WarriorOx/SolderOven/Design Outputs/Solder-Oven-PCB-Front.png

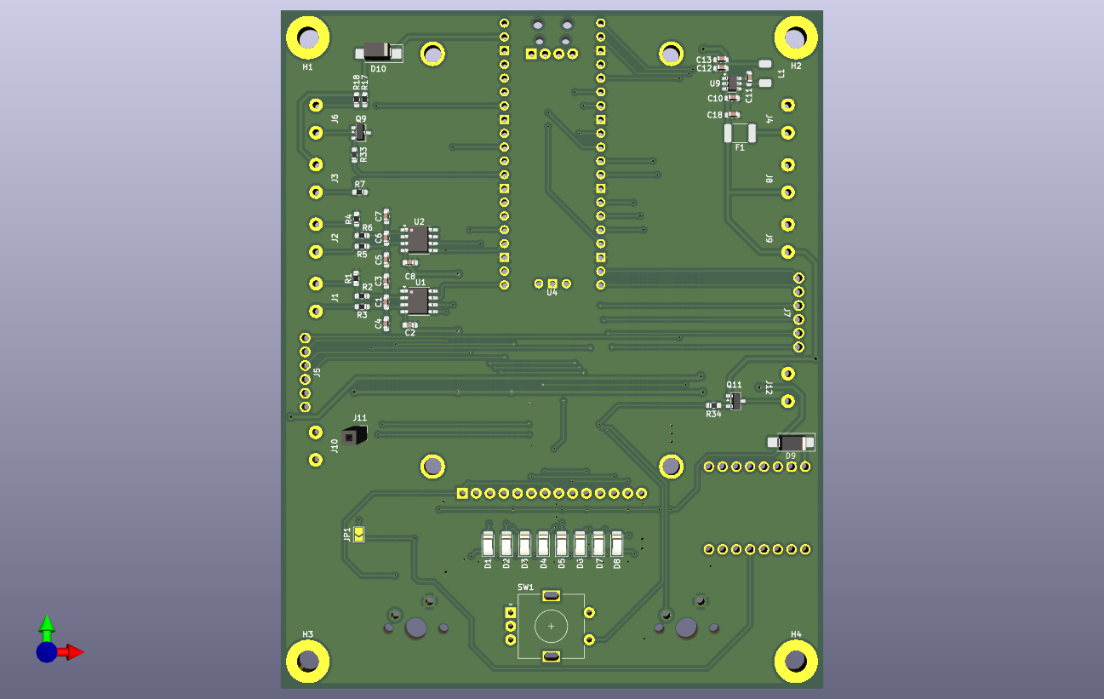
Design Outputs/Solder-Oven-PCB-Front.png
