WarriorOx/SolderOven/Design Outputs/Solder-Oven-PCB-Rear.png

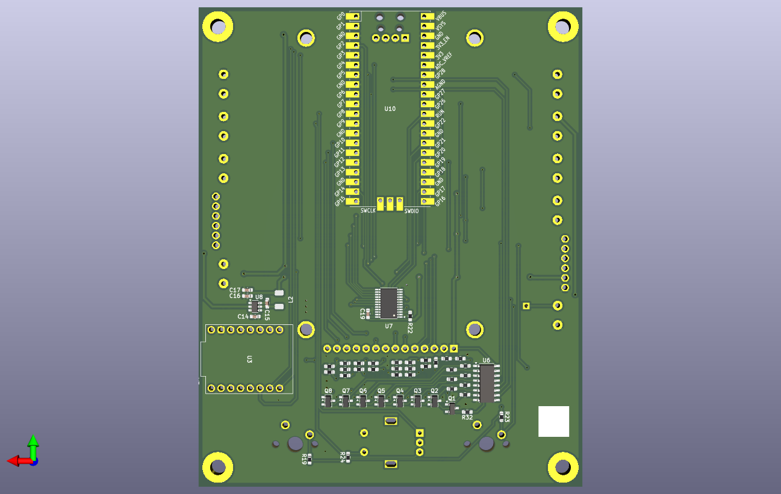
Design Outputs/Solder-Oven-PCB-Rear.png
