WarriorOx/SolderOven/KiCad-Templates-Libraries/README.md

# KiCad Templates & Libraries
## Description
This repository is a collection of KiCad PCB templates, schematic libraries, footprint libraries and 3D models of components. This repository is intended to be added as a sub-module of each PCB project so that libraries can be updated and managed independantly from the PCB project itself.
## Addition Instructions
To add this library to an existing git repo use `git submodule add http://192.168.2.202/WarriorOx/KiCad-Templates-Libraries.git PROJECT_FOLDER/KiCad-Templates-Libraries`

This will allow for the libraries to be referenced relative to the KiCad project instead of needing to be changed when used on a different computer.
<<<<<<< HEAD
<h3>Included Libraries</h3>
*Updated Nov. 28, 2024*
=======
## Included Libraries
*Updated Nov. 26, 2024 *
>>>>>>> 32c0e4cfd789ac8a733560780b6e95adb8c2da2a

- Arduino-Accessories (AliExpress PCB modules designed for use with Arduinos)
- Connectors_Terminals (Screw terminals and Misc. connectors)
- ESP-32 (ESP32 footprints and schematic symbols)
- Inductors (Inductor Footprints)
- IO-Expanders (I/O expanders, I2C and SPI, including DAC, ADC and PWM)
- JLC-X-layer-template (Template KiCad project for X layer PCB with proper design rules)
- MX_Alps_Hybrid-master (MX-style keyswitch footprints for hotswap and regular)
- Random-Keyboard-Parts (Misc. keyboard parts including LEDs and MCUs)
- RP_Pico (Schematic symbol, Footprint and 3D models of Raspberry Pi Pico)
- USB-Ports (Collection of USB ports from LCSC, various data rates)

## Notes
**Need to fix 24 pin USB-C port footprint**
