WarriorOx/SolderOven/Design Outputs/Schematic P1.png

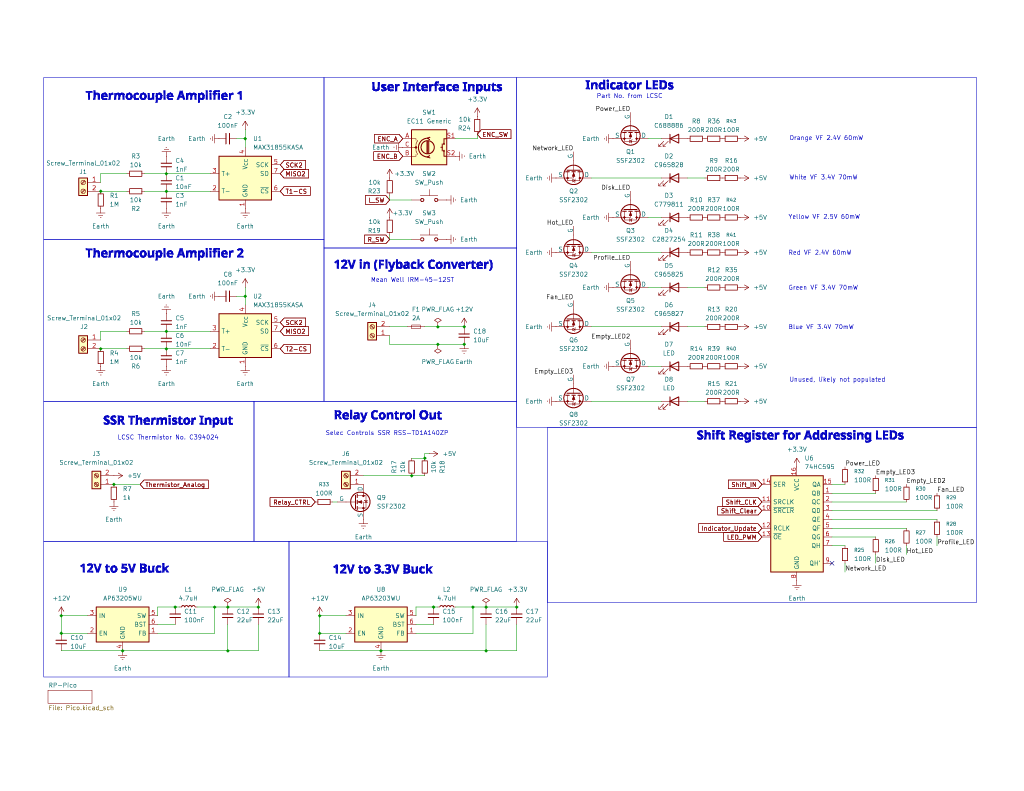
Design Outputs/Schematic P1.png
