WarriorOx/SolderOven/Design Outputs/Schematic P2.png

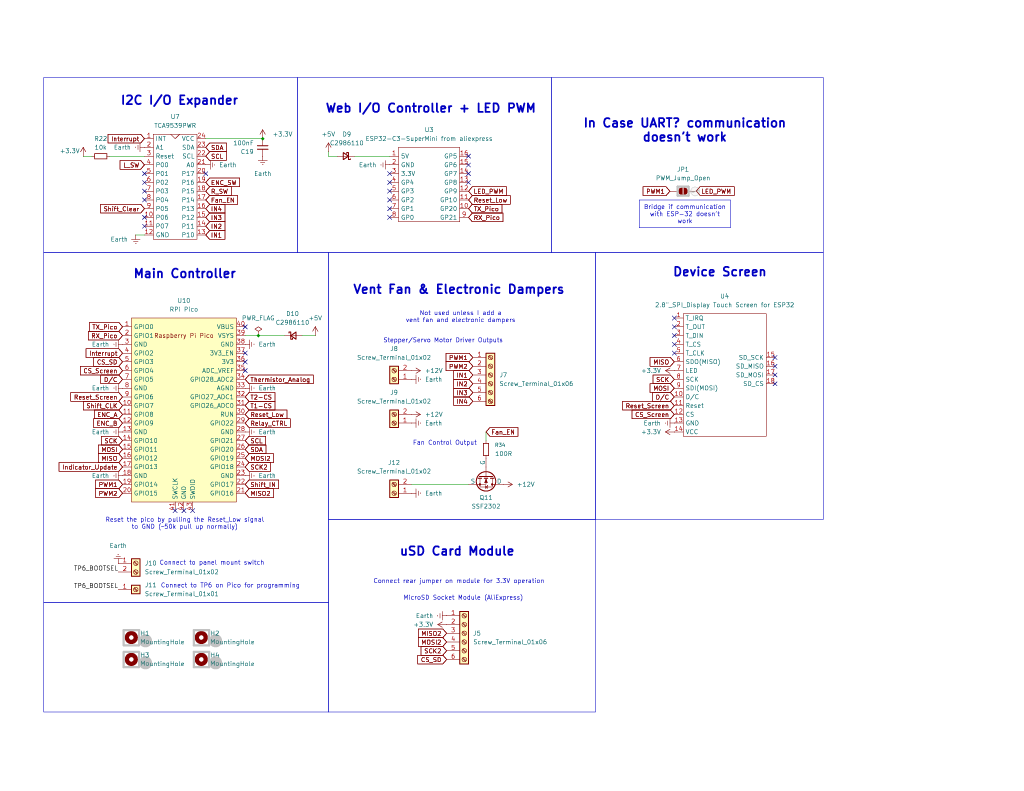
Design Outputs/Schematic P2.png
