WarriorOx/SolderOven/Solder-Oven-BOM.pdf

## Solder-Oven-BOM

Reference | Value | Footprint | Qty | Description | Link
C1,C6 | 10nF | Capacitor_SMD:C_0603_1608M | 2 | Unpolarized capacitor | LCSC(100) (https://www.lcsc.com/product-detail/Multilayer-Ceramic-Capacitors-MLCC-SMD-SMT_YAGEO-CC0603KRX7R8BB103_C327204.html)
C2,C8,C11,C15,C19 | 100nF | Capacitor_SMD:C_0603_1608M | 5 | Unpolarized capacitor | LCSC(100) (https://www.lcsc.com/product-detail/Multilayer-Ceramic-Capacitors-MLCC-SMD-SMT_Walsin-Tech-Corp-0603B104K160CT_C80516.html)
C3,C4,C5,C7 | 1nF | Capacitor_SMD:C_0603_1608M | 4 | Unpolarized capacitor | LCSC(100) (https://www.lcsc.com/product-detail/Multilayer-Ceramic-Capacitors-MLCC-SMD-SMT_Walsin-Tech-Corp-0603B102K160CT_C163169.html)
C10,C14,C18 | 10uF | Capacitor_SMD:C_0603_1608M | 3 | Unpolarized capacitor | LCSC(20) (https://www.lcsc.com/product-detail/Multilayer-Ceramic-Capacitors-MLCC-SMD-SMT_Samsung-Electro-Mechanics-CL10A106MA8NRNC_C96446.html)
C12,C13,C16,C17 | 22uF | Capacitor_SMD:C_0603_1608M | 4 | Unpolarized capacitor | LCSC(30) (https://www.lcsc.com/product-detail/Multilayer-Ceramic-Capacitors-MLCC-SMD-SMT_Samsung-Electro-Mechanics-CL10A226MP8NUNE_C86295.html)
D1 | Orange LED | LED_SMD:LED_1206_3216Metri | 1 | | LCSC(50) (https://www.lcsc.com/product-detail/LED-Indication-Discrete_TUOZHAN-TZ-P2-1206-0-TCS2-1-0T_C688886.html)
D2 | White LED | LED_SMD:LED_1206_3216Metri | 1 | | LCSC(50) (https://www.lcsc.com/product-detail/LED-Indication-Discrete_XINGLIGHT-XL-3216UWC_C965828.html)
D3 | Yellow LED | LED_SMD:LED_1206_3216Metri | 1 | | LCSC(50) (https://www.lcsc.com/product-detail/LED-Indication-Discrete_TUOZHAN-TZ-P2-1206YTCS2-0-9T_C779811.html)
D4 | Red LED | LED_SMD:LED_1206_3216Metri | 1 | | LCSC(50) (https://www.lcsc.com/product-detail/LED-Indication-Discrete_TUOZHAN-P2-1206RTCS2-0-9T-F_C2827254.html)
D5 | Green LED | LED_SMD:LED_1206_3216Metri | 1 | | LCSC(50) (https://www.lcsc.com/product-detail/LED-Indication-Discrete_XINGLIGHT-XL-3216UGC_C965825.html)
D6 | Blue LED | LED_SMD:LED_1206_3216Metri | 1 | | LCSC(50) (https://www.lcsc.com/product-detail/LED-Indication-Discrete_XINGLIGHT-XL-3216UBC_C965827.html)
D7,D8 | LED | LED_SMD:LED_1206_3216Metri | 2
D9,D10 | C2986110 | Diode_SMD:D_SMA_Handsolder | 2 | Schottky diode | LCSC(50) (https://www.lcsc.com/product-detail/Schottky-Diodes_GOODWORK-SS14_C2986110.html)
F1 | 2A | Fuse:Fuse_1812_4532Metric_P | 1 | Fuse | LCSC(5) (https://www.lcsc.com/product-detail/Resettable-Fuses_Bel-span-style-background-color-ff0-Fuse-span-0ZCG0110BF2B_C3760730.html)
J1,J2,J3,J4,J6,J8,J9, J10,J12 | Screw_Termin al_01x02 | Connectors_Terminals:1x2 5.0 | 9 | 1x2 5.08mm Screw Terminal | LCSC(50) (https://www.lcsc.com/product-detail/Screw-Terminal-Blocks_JILN-JL500-50802G01_C709041.html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)
J5,J7 | Screw_Termin al_01x06 | Connectors_Terminals:1x6 2.5 | 2 | 1x6 2.54mm Screw Terminal | LCSC(2) (https://www.lcsc.com/product-detail/Screw-Terminal-Blocks_MAX-MX128-2-54-06P-GN01-Cu-Y-A_C5188446.html)
J11 | Screw_Termin al_01x01 | Solder a wire to it | 1 | 1x1 2.54mm Pin Header
L1,L2 | 4.7uH | Inductors:LCSCC22463808 | 2 | Inductor | LCSC(5) (https://www.lcsc.com/product-detail/Inductors-SMD_TECHFUSE-SL0420-4R7M_C22463808.html)
Q1,Q2,Q3,Q4,Q5,Q6, Q7,Q8,Q9,Q11 | SSF2302 | Package_TO_SOT_SMD:SOT-23 | 10 | N-MOSFET transistor, drain/source/gate
R1,R4 | 1M | Resistor_SMD:R_0603_1608Met | 2 | Resistor | LCSC(100) (https://www.lcsc.com/product-detail/Chip-Resistor-Surface-Mount_FOJAN-FRC0603F1004TS_C2907003.html)
R2,R3,R5,R6,R17,R18 ,R22 | 10k | Resistor_SMD:R_0603_1608Met | 7 | Resistor
R7 | 1k | Resistor_SMD:R_0603_1608Met | 1 | Resistor | LCSC(100) (https://www.lcsc.com/product-detail/Chip-Resistor-Surface-Mount_VO-SCR0603J1K_C3017736.html)
R8,R9,R10,R11,R12,R 13,R14,R15,R16,R20, R21 | 200R | Resistor_SMD:R_0603_1608Met | 11 | Resistor
SW1 | EC11 Generic | Rotary_Encoder:RotaryEncode | 1 | Rotary encoder
SW2,SW3 | SW_Push | MX_Only:MXOnly-1U-NoLED | 2 | Push button switch, generic, two pins
U1,U2 | MAX31855KAS A | Package_SO:SOIC-8_3.9x4.9 | 2 | Cold Junction K-type Thermocouple Interface, SPI, SOIC-8 | LCSC(2) (https://www.lcsc.com/product-detail/ADCs-DACs-Special-Purpose_Analog-Devices-Inc-Maxim-Integrated-MAX31855KASA-T_C52028.html)
U3 | ESP32-C3-SuperMini | ESP-32:ESP32-C3_SUPERMINI | 1 | 2x 1x8 2.54mm pins

U4 | 2.8"_SPI_Displ ay Touch Screen | Arduino-Accesories:2.8in TFT D | 1 | 1x14 2.54mm pins
U5 | TCA9539PWR | Package_SO:TSSOP-24_4.4x7 | 1 | I2C I/O Expander | LCSC(1) (https://www.lcsc.com/product-detail/I-O-Expanders_Texas-Instruments-TCA9539PWR_C131972.html)
U6 | 74HC595 | Package_SO:SOP-16_3.9x9.9 | 1 | 8-bit serial in/out Shift Register 3-State Outputs | LCSC(10) (https://www.lcsc.com/product-detail/Shift-Registers_GR-74HC595_C18164493.html)
U8 | AP63203WU | Package_TO_SOT_SMD:TSOT-2 | 1 | 2A, 1.1MHz Buck DC/DC Converter, fixed 3.3V output voltage, TSOT-23-6 | LCSC(5) (https://www.lcsc.com/product-detail/DC-DC-Converters_Diodes-Incorporated-AP63203WU-7_C780769.html)
U9 | AP63205WU | Package_TO_SOT_SMD:TSOT-2 | 1 | 2A, 1.1MHz Buck DC/DC Converter, fixed 5.0V output voltage, TSOT-23-6 | LCSC(1) (https://www.lcsc.com/product-detail/DC-DC-Converters_Diodes-Incorporated-AP63205WU-7_C2071056.html)
U10 | RPi Pico | RPI-Pico:RPi_Pico_SMD_TH | 1 | 2x 1x20 2.54mm pins
| Solid State Relay | | 1 | | Digikey(1) (https://www.digikey.ca/en/products/detail/picker-components/PCS15-D-240A-40ZL/20994534)
R25,R26,R27,R28,R2 9,R30,R31,R32,R33,R 34,R40,R41,R42,R43 | 100R | Resistor_SMD:R_0603_1608Met | 14 | Resistor
| 1x8 2.54mm pin header Male | ESP-32:ESP32-C3_SUPERMINI | 2 | Male Pins | LCSC(10) (https://www.lcsc.com/product-detail/Pin-Headers_DEALON-DZ254R-11-08-63_C2935914.html)
| 1x8 2.54mm pin header Female | ESP-32:ESP32-C3_SUPERMINI | 2 | Female Pins | LCSC(10) (https://www.lcsc.com/product-detail/Female-Headers_JILN-22850108ANG1SYA01_C429957.html)
| 1x14 2.54mm pin header Male | Arduino-Accesories:2.8in TFT D | 1 | Male Pins | LCSC(10) (https://www.lcsc.com/product-detail/Pin-Headers_CONNFLY-Elec-DS1021-1x14SF11-B_C7430370.html)
| 1x14 2.54mm pin header Female | Arduino-Accesories:2.8in TFT D | 1 | Female Pins | LCSC(5) (https://www.lcsc.com/product-detail/Female-Headers_Shenzhen-Kinghelm-Elec-KH-2-54FH-1X14P-H8-5_C2905420.html)
| 1x20 2.54mm pin header Male | RPI-Pico:RPi_Pico_SMD_TH | 2 | Male Pins | LCSC(10) (https://www.lcsc.com/product-detail/Pin-Headers_JILN-12251120CNG0S115005_C429964.html)
| 1x20 2.54mm pin header Female | RPI-Pico:RPi_Pico_SMD_TH | 2 | Female Pins | LCSC(5) (https://www.lcsc.com/product-detail/Female-Headers_Shenzhen-Kinghelm-Elec-KH-2-54FH-1X20P-H8-5_C2905423.html)
| 16mm Panel Mount Switch | BOOTSEL Button | 1 | | AliExpress(1) (https://www.aliexpress.com/item/4000830670631.html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)
| | | 1 | Panel Mount USB-C to USB-C | AliExpress(1) (https://www.aliexpress.com/item/1005006161284502.html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)

1 | Panel Mount USB-C to Micro B | AliExpress(1) (https://www.aliexpress.com/item/1005006161284502.html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)
1 | Mean Well 12V 3.8A PSU | Digikey(1) (https://www.digikey.ca/en/products/detail/mean-well-usa-inc/irm-45-12st/7704683)
