WarriorOx/SolderOven/Design Outputs/BOM2.png

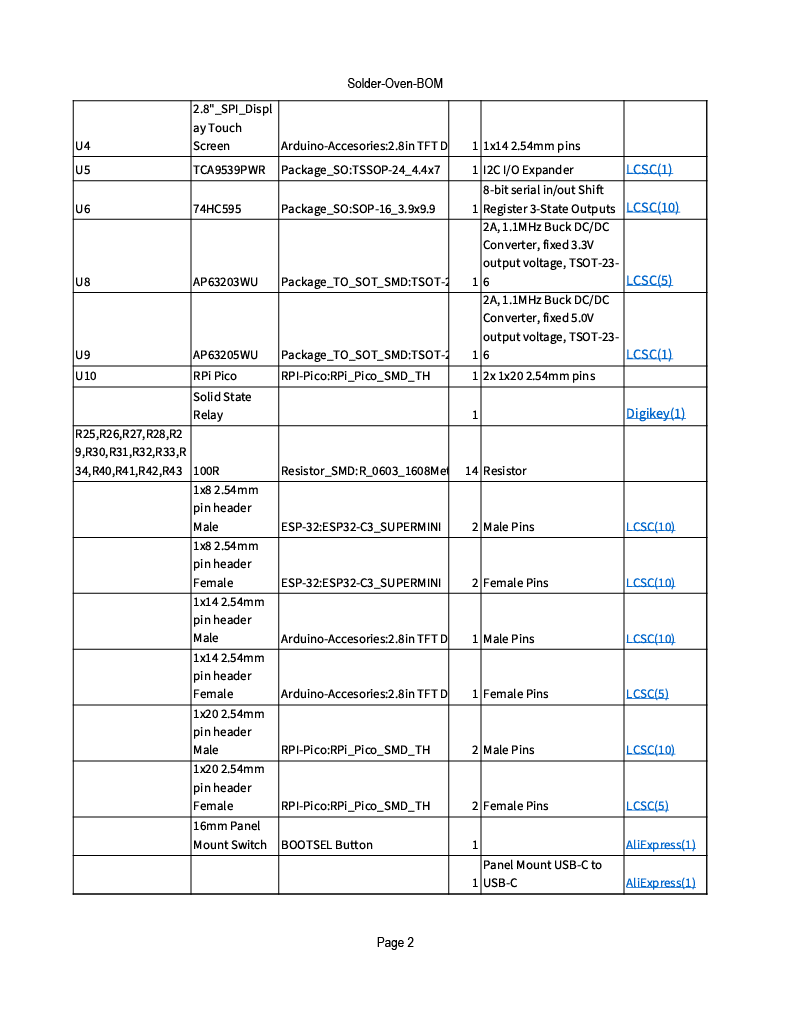
Design Outputs/BOM2.png
