WarriorOx/SolderOven/Design Outputs/BOM3.png

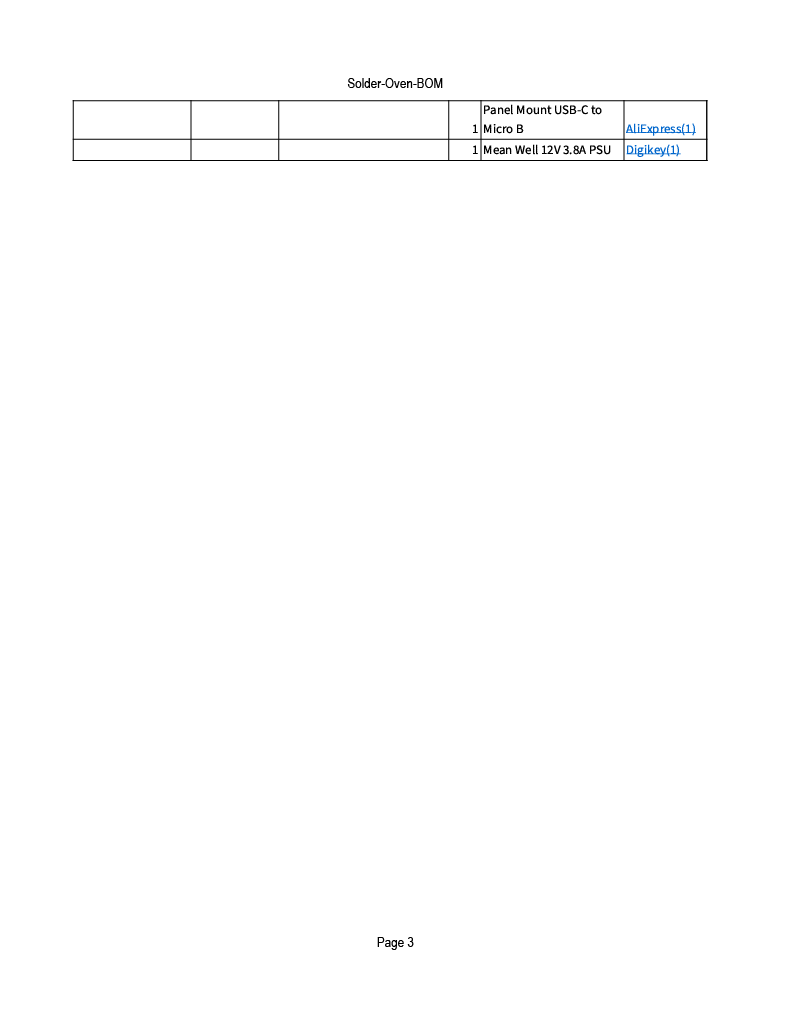
Design Outputs/BOM3.png
