WarriorOx/SolderOven/Design Outputs/BOM-1.png

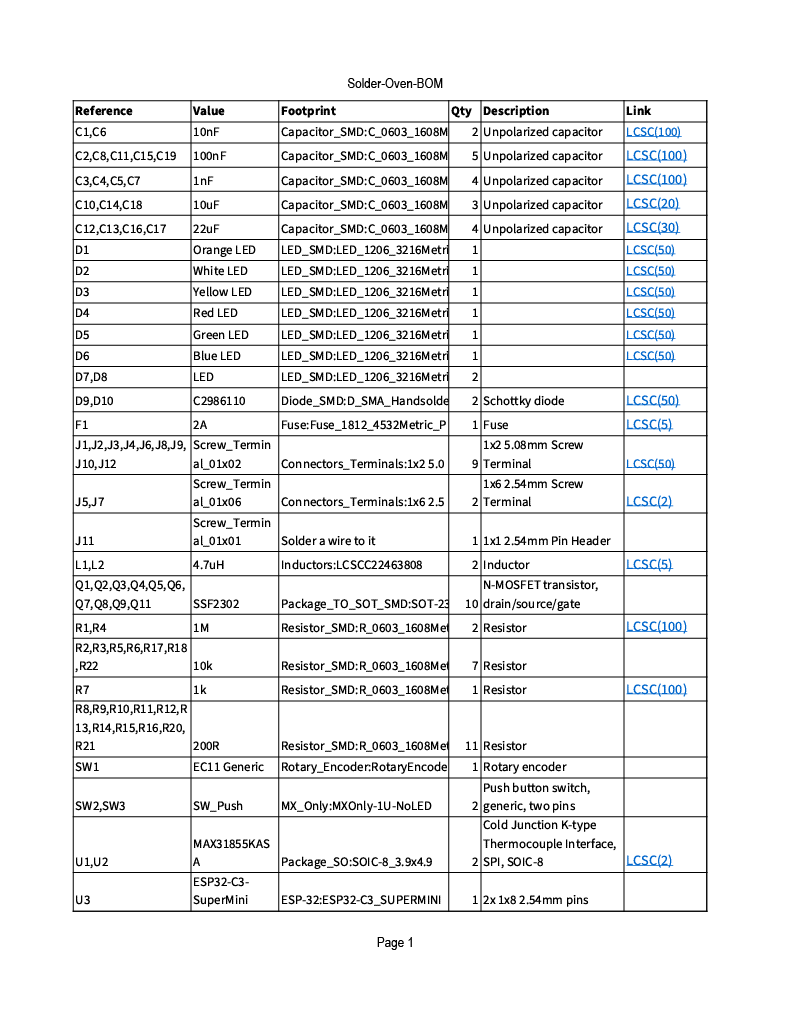
Design Outputs/BOM-1.png
