WarriorOx/SolderOven/Design Outputs/Solder Oven Front.png

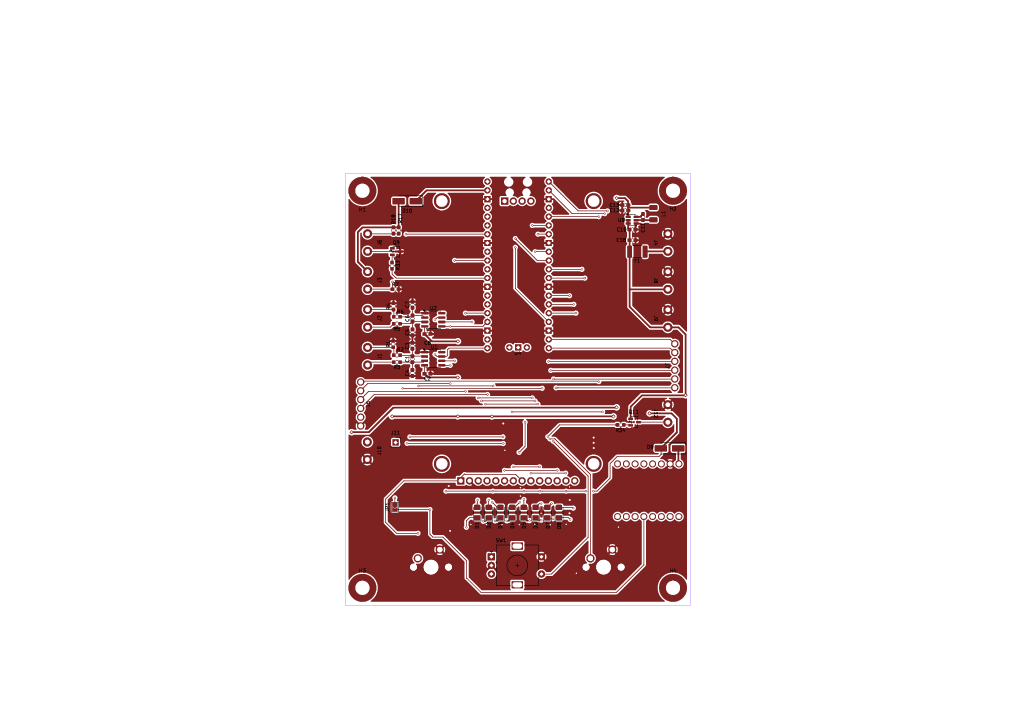
Design Outputs/Solder Oven Front.png
