WarriorOx/SolderOven/Design Outputs/Solder Oven Rear.png

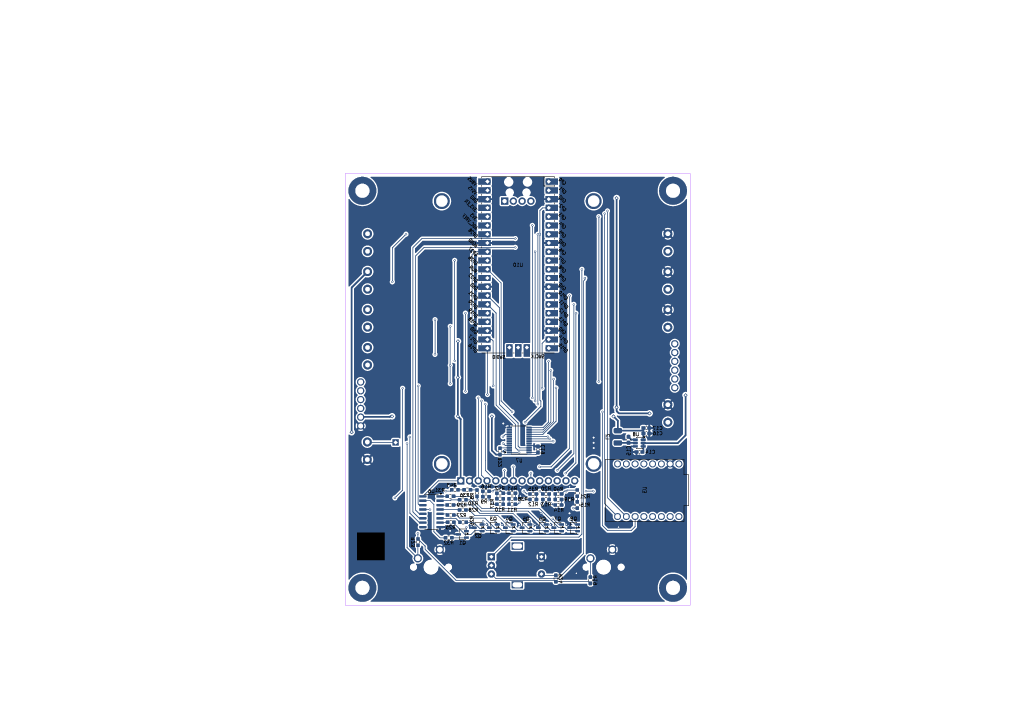
Design Outputs/Solder Oven Rear.png
