WarriorOx/SolderOven/Design Outputs/Schematics.pdf

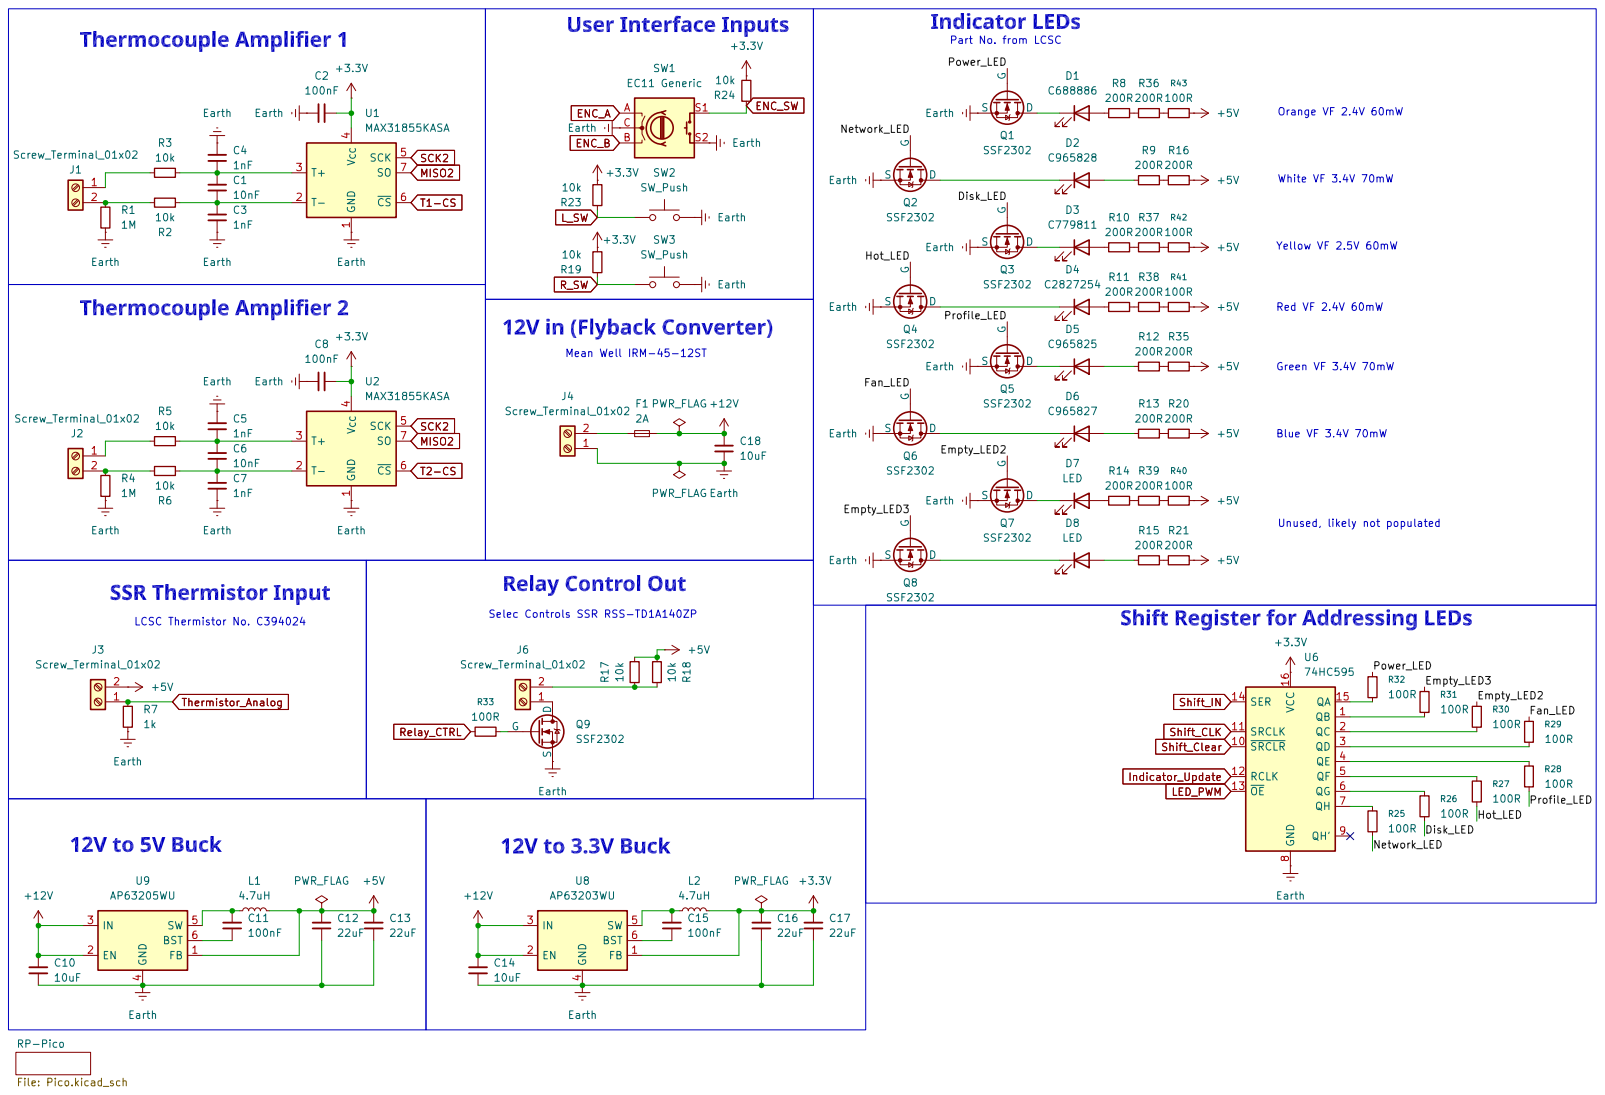
[picture p14: page 1]

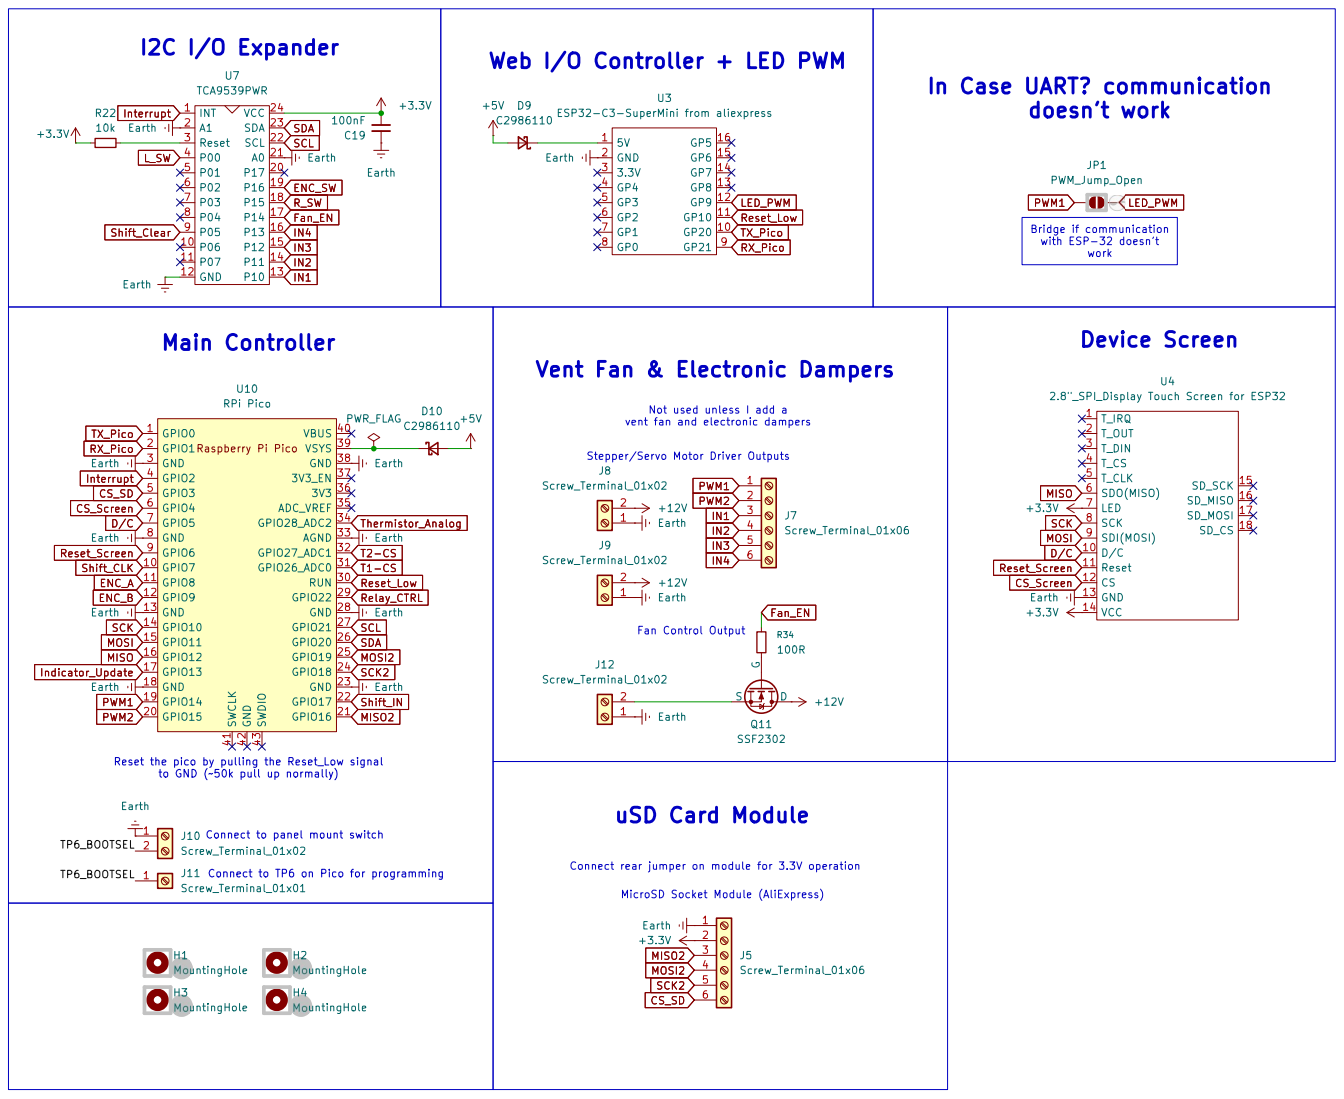
[picture p15: page 2]
