WarriorOx/SolderOven/Design Outputs/Solder Oven Front.pdf

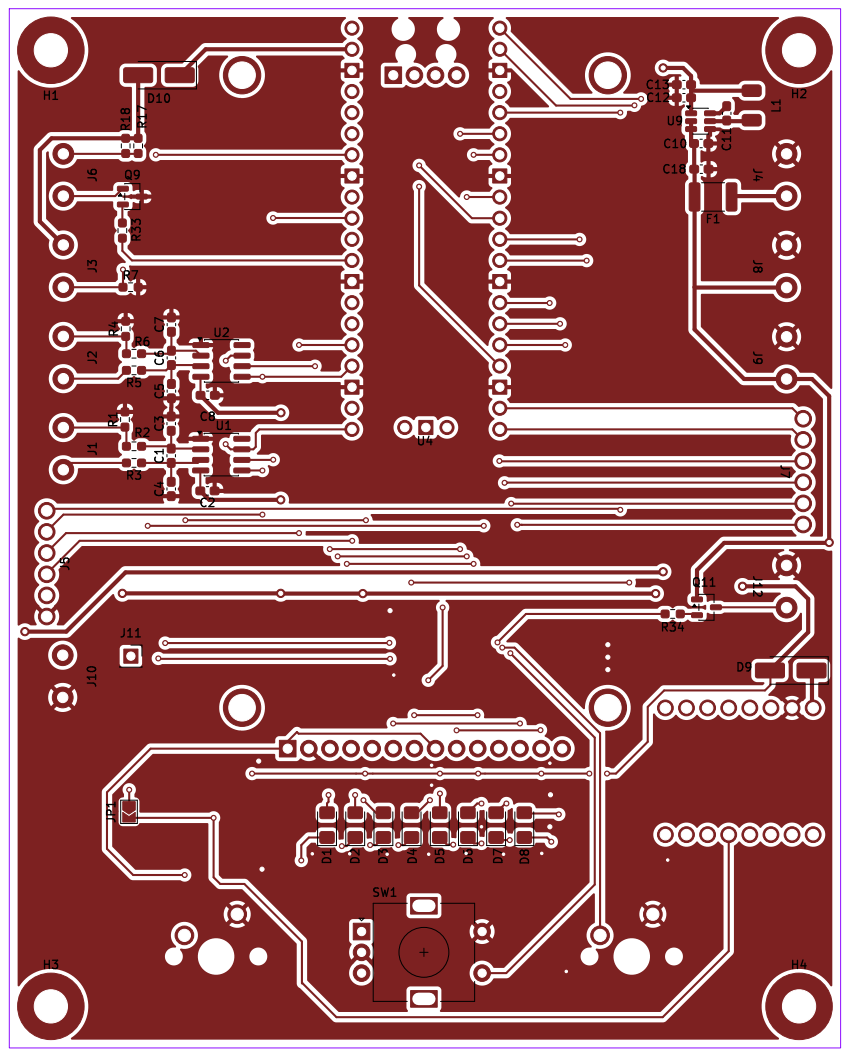
[picture p16: page 1]
