WarriorOx/SolderOven/Design Outputs/Solder Oven Rear.pdf

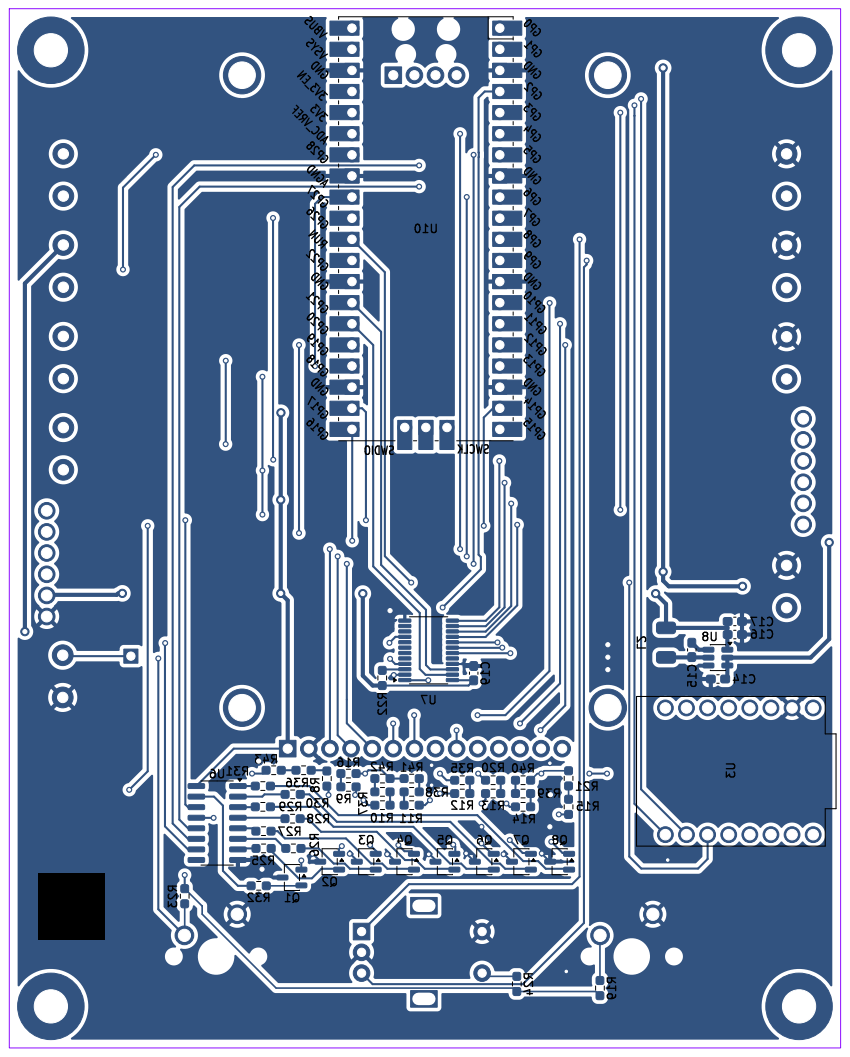
[picture p17: page 1]
