WarriorOx/SolderOven/Solder-Oven-PCB-V1.kicad_pcb

## KiCad design Solder-Oven-PCB-V1.kicad_pcb (2025-11-13)

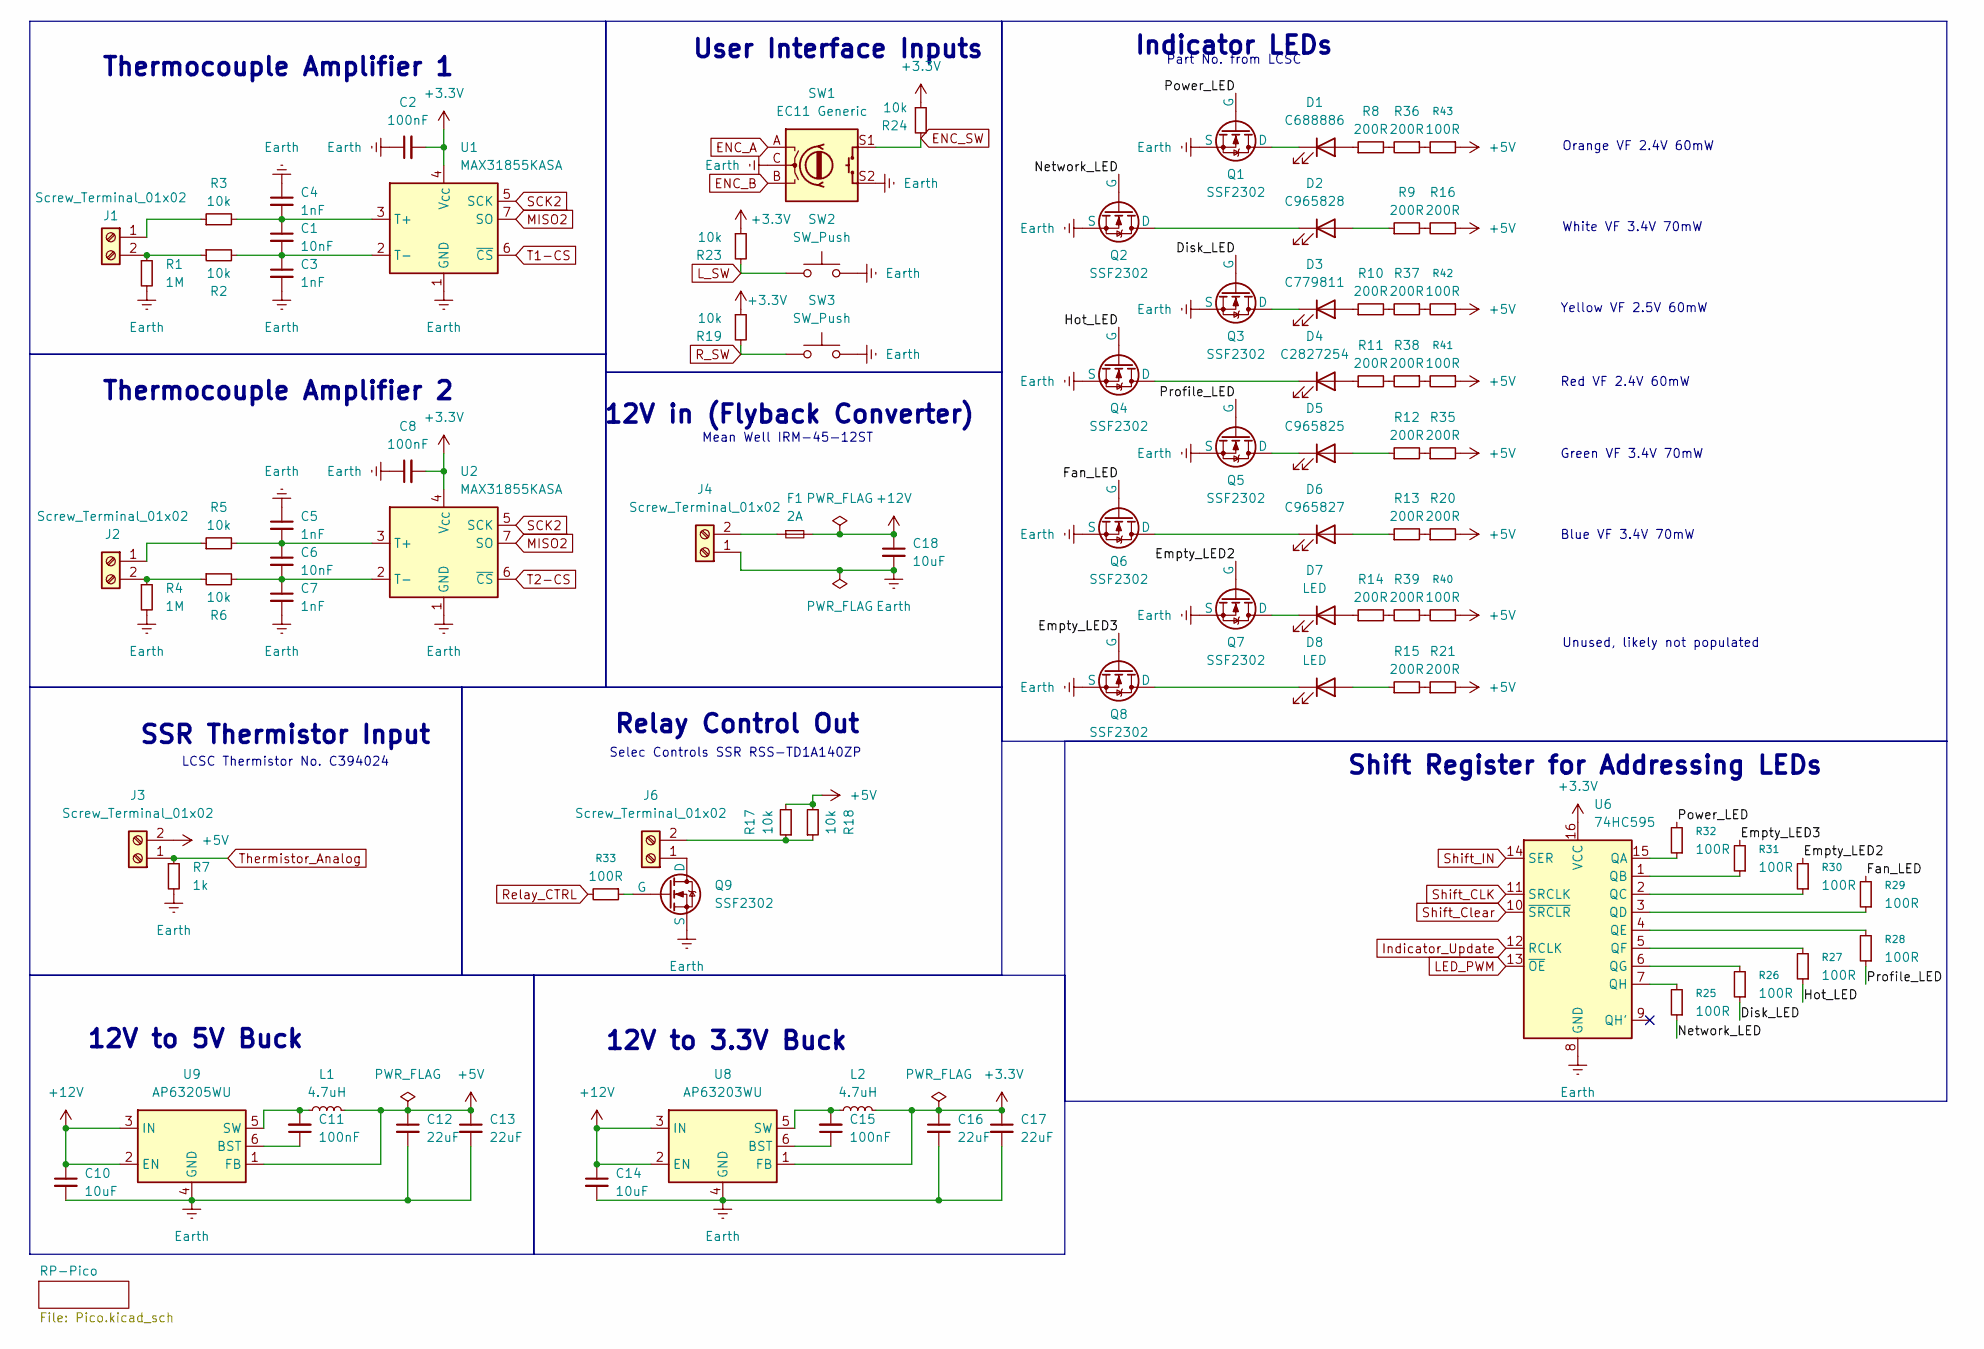
[picture p18: schematic Solder-Oven-PCB-V1.kicad_sch]

Parts:
C1, C6: 10nF; C_0603_1608Metric_Pad1.08x0.95mm_HandSolder
C2, C8, C11, C15: 100nF; C_0603_1608Metric_Pad1.08x0.95mm_HandSolder
C3, C4, C5, C7: 1nF; C_0603_1608Metric_Pad1.08x0.95mm_HandSolder
C10, C14, C18: 10uF; C_0603_1608Metric_Pad1.08x0.95mm_HandSolder
C12, C13, C16, C17: 22uF; C_0603_1608Metric_Pad1.08x0.95mm_HandSolder
D1: C688886; LED_1206_3216Metric_Pad1.42x1.75mm_HandSolder
D2: C965828; LED_1206_3216Metric_Pad1.42x1.75mm_HandSolder
D3: C779811; LED_1206_3216Metric_Pad1.42x1.75mm_HandSolder
D4: C2827254; LED_1206_3216Metric_Pad1.42x1.75mm_HandSolder
D5: C965825; LED_1206_3216Metric_Pad1.42x1.75mm_HandSolder
D6: C965827; LED_1206_3216Metric_Pad1.42x1.75mm_HandSolder
D7, D8: LED; LED_1206_3216Metric_Pad1.42x1.75mm_HandSolder
F1: 2A; Fuse_1812_4532Metric_Pad1.30x3.40mm_HandSolder
J1, J2, J3, J4, J6: Screw_Terminal_01x02; 1x2 5.08mm Screw Terminal
L1, L2: 4.7uH; LCSCC22463808
Q1, Q2, Q3, Q4, Q5, Q6, Q7, Q8, Q9: SSF2302; SOT-23-3
R1, R4: 1M; R_0603_1608Metric_Pad0.98x0.95mm_HandSolder
R2, R3, R5, R6, R17, R18, R19, R23, R24: 10k; R_0603_1608Metric_Pad0.98x0.95mm_HandSolder
R7: 1k; R_0603_1608Metric_Pad0.98x0.95mm_HandSolder
R8, R9, R10, R11, R12, R13, R14, R15, R16, R20, R21, R35, R36, R37, R38, R39: 200R; R_0603_1608Metric_Pad0.98x0.95mm_HandSolder
R25, R26, R27, R28, R29, R30, R31, R32, R33, R40, R41, R42, R43: 100R; R_0603_1608Metric_Pad0.98x0.95mm_HandSolder
SW1: EC11 Generic; RotaryEncoder_Alps_EC11E-Switch_Vertical_H20mm
SW2, SW3: SW_Push; MXOnly-1U-NoLED
U1, U2: MAX31855KASA; SOIC-8_3.9x4.9mm_P1.27mm
U6: 74HC595; SOP-16_3.9x9.9mm_P1.27mm
U8: AP63203WU; TSOT-23-6
U9: AP63205WU; TSOT-23-6

Connections:
+3.3V: C2.2, C8.2, C16.1, C17.1, L2.2, R19.1, R23.1, R24.1, U1.4 (V_{CC}), U2.4 (V_{CC}), U6.16 (VCC), U8.1 (FB); also elsewhere on the board
+5V: C12.1, C13.1, J3.2, L1.2, R16.1, R17.2, R18.2, R20.2, R21.2, R35.2, R40.1, R41.1, R42.1, R43.1, U9.1 (FB); also elsewhere on the board
+12V: C10.1, C14.1, C18.1, F1.2, U8.2 (EN), U8.3 (IN), U9.2 (EN), U9.3 (IN); also elsewhere on the board
/Disk_LED: Q3.2 (G), R26.1
/Empty_LED2: Q7.2 (G), R30.2
/Empty_LED3: Q8.2 (G), R31.2
/Fan_LED: Q6.2 (G), R29.2
/Hot_LED: Q4.2 (G), R27.1
/Network_LED: Q2.2 (G), R25.1
/Power_LED: Q1.2 (G), R32.2
/Profile_LED: Q5.2 (G), R28.1
ENC_A: SW1.A; also elsewhere on the board
ENC_B: SW1.B; also elsewhere on the board
ENC_SW: R24.2, SW1.S1; also elsewhere on the board
Earth: C2.1, C3.2, C4.1, C5.1, C7.2, C8.1, C10.2, C12.2, C13.2, C14.2, C16.2, C17.2, C18.2, J4.1, Q1.3 (S), Q2.3 (S), Q3.3 (S), Q4.3 (S), Q5.3 (S), Q6.3 (S), Q7.3 (S), Q8.3 (S), Q9.3 (S), R1.2, R4.2, R7.2, SW1.C, SW1.S2, SW2.2, SW3.2, U1.1 (GND), U2.1 (GND), U6.8 (GND), U8.4 (GND), U9.4 (GND); also elsewhere on the board
Indicator_Update: U6.12 (RCLK); also elsewhere on the board
LED_PWM: U6.13 (~OE); also elsewhere on the board
L_SW: R23.2, SW2.1; also elsewhere on the board
MISO2: U1.7 (SO), U2.7 (SO); also elsewhere on the board
unnamed: D1.2 (A), R8.1
unnamed: D1.1 (K), Q1.1 (D)
unnamed: D2.2 (A), R9.1
unnamed: D2.1 (K), Q2.1 (D)
unnamed: D3.2 (A), R10.1
unnamed: D3.1 (K), Q3.1 (D)
unnamed: D4.2 (A), R11.1
unnamed: D4.1 (K), Q4.1 (D)
unnamed: D5.2 (A), R12.1
unnamed: D5.1 (K), Q5.1 (D)
unnamed: D6.2 (A), R13.1
unnamed: D6.1 (K), Q6.1 (D)
unnamed: D7.2 (A), R14.1
unnamed: D7.1 (K), Q7.1 (D)
unnamed: D8.2 (A), R15.1
unnamed: D8.1 (K), Q8.1 (D)
unnamed: J1.1, R3.1
unnamed: J1.2, R1.1, R2.1
unnamed: J2.1, R5.1
unnamed: J2.2, R4.1, R6.1
unnamed: F1.1, J4.2
unnamed: J6.1, Q9.1 (D)
unnamed: J6.2, R17.1, R18.1
unnamed: Q9.2 (G), R33.1
unnamed: R10.2, R37.2
unnamed: R11.2, R38.2
unnamed: R12.2, R35.1
unnamed: R13.2, R20.1
unnamed: R14.2, R39.2
unnamed: R15.2, R21.1
unnamed: R9.2, R16.2
unnamed: R36.1, R43.2
unnamed: R8.2, R36.2
unnamed: R37.1, R42.2
unnamed: R38.1, R41.2
unnamed: R39.1, R40.2
unnamed: C1.1, C4.2, R3.2, U1.3 (T+)
unnamed: C1.2, C3.1, R2.2, U1.2 (T-)
unnamed: C5.2, C6.1, R5.2, U2.3 (T+)
unnamed: C6.2, C7.1, R6.2, U2.2 (T-)
unnamed: R32.1, U6.15 (QA)
unnamed: R31.1, U6.1 (QB)
unnamed: R30.1, U6.2 (QC)
unnamed: R29.1, U6.3 (QD)
unnamed: R28.2, U6.4 (QE)
unnamed: R27.2, U6.5 (QF)
unnamed: R26.2, U6.6 (QG)
unnamed: R25.2, U6.7 (QH)
unnamed: C15.1, U8.6 (BST)
unnamed: C15.2, L2.1, U8.5 (SW)
unnamed: C11.1, U9.6 (BST)
unnamed: C11.2, L1.1, U9.5 (SW)
R_SW: R19.2, SW3.1; also elsewhere on the board
Relay_CTRL: R33.2; also elsewhere on the board
SCK2: U1.5 (SCK), U2.5 (SCK); also elsewhere on the board
Shift_CLK: U6.11 (SRCLK); also elsewhere on the board
Shift_Clear: U6.10 (~SRCLR); also elsewhere on the board
Shift_IN: U6.14 (SER); also elsewhere on the board
T1-CS: U1.6 (~CS); also elsewhere on the board
T2-CS: U2.6 (~CS); also elsewhere on the board
Thermistor_Analog: J3.1, R7.1; also elsewhere on the board

Notes on the sheet:
Thermocouple Amplifier 1
Yellow VF 2.5V 60mW
Orange VF 2.4V 60mW
Part No. from LCSC
User Interface Inputs
White VF 3.4V 70mW
Thermocouple Amplifier 2
Mean Well IRM-45-12ST
12V to 3.3V Buck
Blue VF 3.4V 70mW
LCSC Thermistor No. C394024
Green VF 3.4V 70mW
Shift Register for Addressing LEDs
SSR Thermistor Input
Red VF 2.4V 60mW
Unused, likely not populated
12V to 5V Buck
Relay Control Out
Indicator LEDs
12V in (Flyback Converter)
Selec Controls SSR RSS-TD1A140ZP

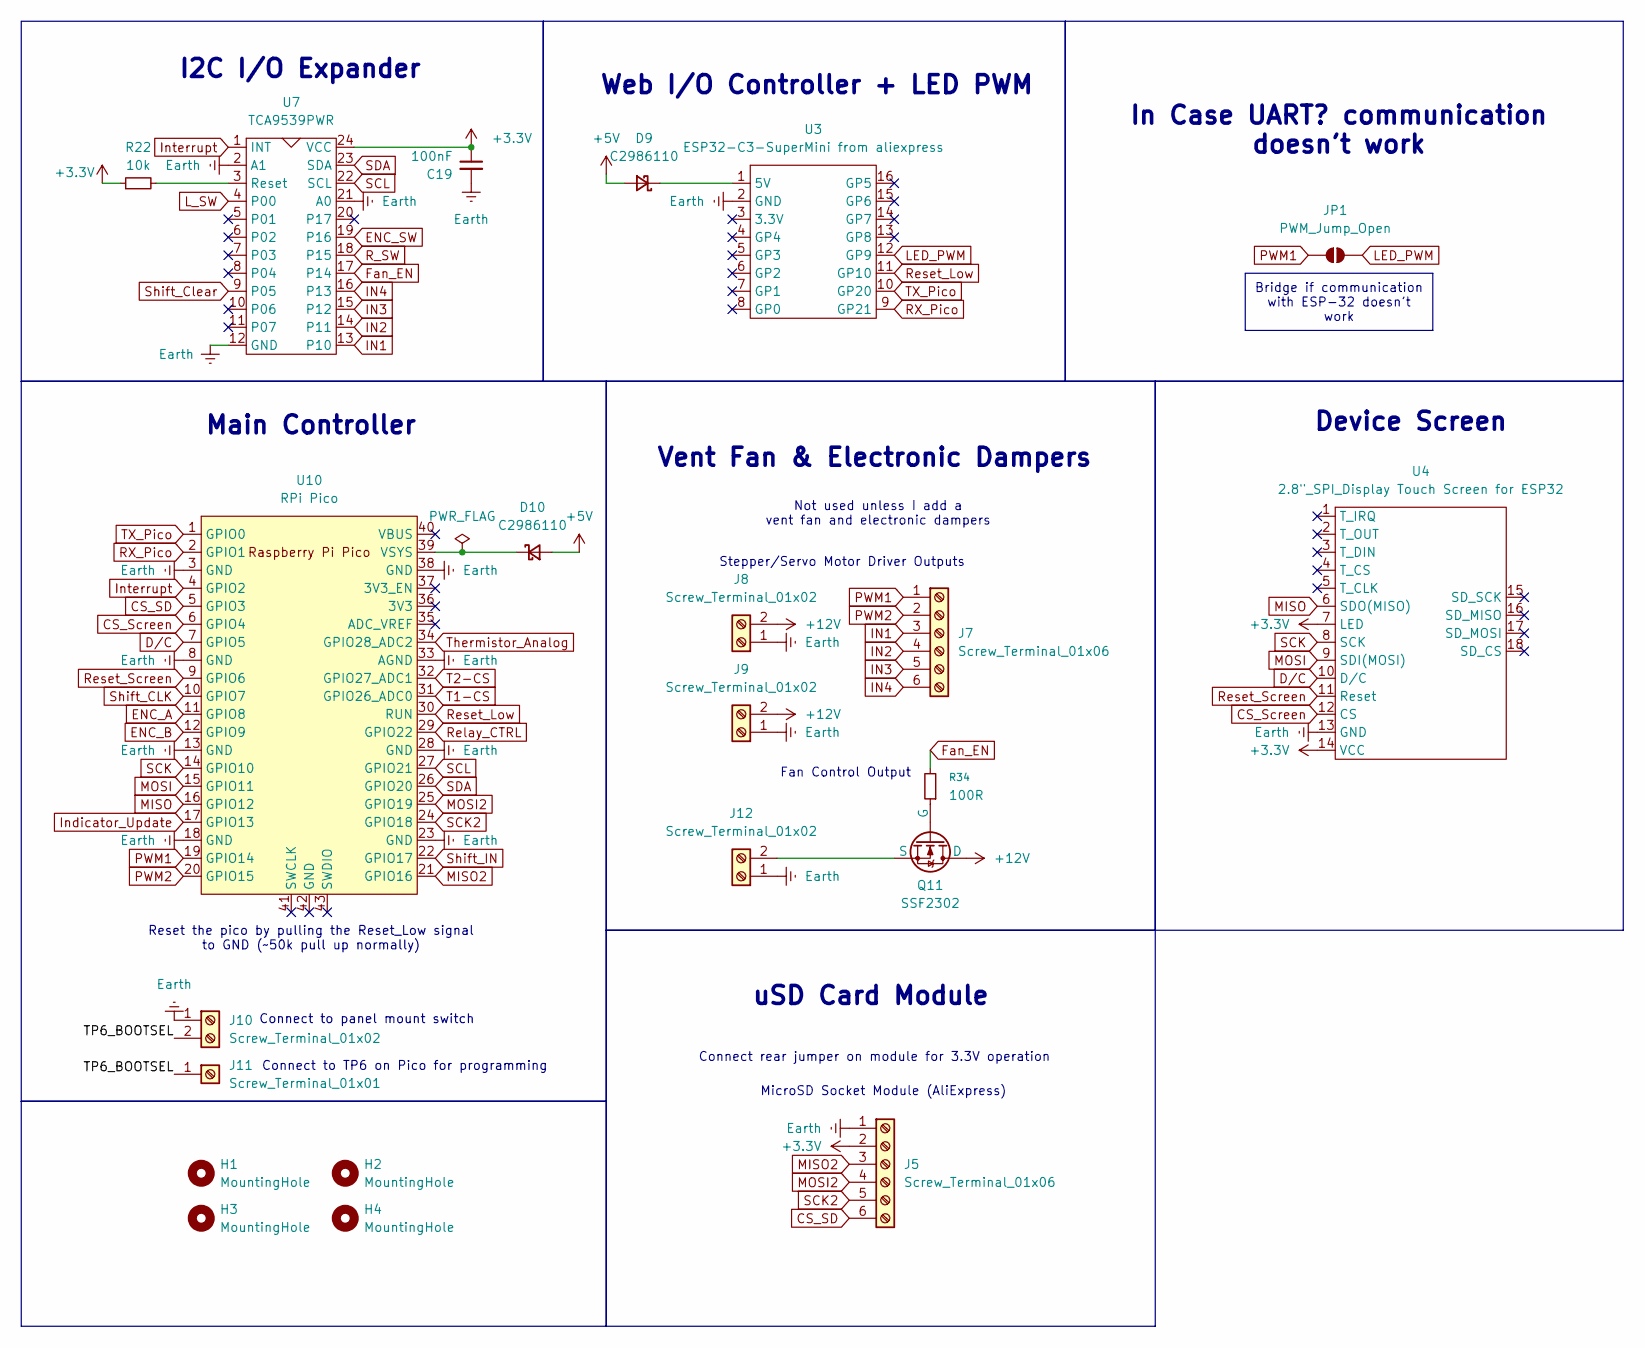
[picture p19: schematic Pico.kicad_sch]

Parts:
C19: 100nF; C_0603_1608Metric_Pad1.08x0.95mm_HandSolder
D9, D10: C2986110; D_SMA_Handsoldering
H1, H2, H3, H4: MountingHole; MountingHole_4mm_Pad
J5, J7: Screw_Terminal_01x06; 1x6 2.54mm Screw Terminal
J8, J9, J10, J12: Screw_Terminal_01x02; 1x2 5.08mm Screw Terminal
J11: Screw_Terminal_01x01; PinSocket_1x01_P2.54mm_Vertical
JP1: PWM_Jump_Open; SolderJumper-2_P1.3mm_Open_TrianglePad1.0x1.5mm
Q11: SSF2302; SOT-23-3
R22: 10k; R_0603_1608Metric_Pad0.98x0.95mm_HandSolder
R34: 100R; R_0603_1608Metric_Pad0.98x0.95mm_HandSolder
U3: ESP32-C3-SuperMini from aliexpress; ESP32-C3_SUPERMINI
U4: 2.8"_SPI_Display Touch Screen for ESP32; 2.8in TFT Display
U7: TCA9539PWR; TSSOP-24_4.4x7.8mm_P0.65mm
U10: RPi Pico; RPi_Pico_SMD_TH

Connections:
+3.3V: C19.1, J5.2, R22.1, U4.7 (LED), U4.14 (VCC), U7.24 (VCC); also elsewhere on the board
+5V: D9.2 (A), D10.2 (A); also elsewhere on the board
+12V: J8.2, J9.2, Q11.1 (D); also elsewhere on the board
/RP-Pico/TP6_BOOTSEL: J10.2, J11.1
CS_SD: J5.6, U10.5 (GPIO3)
CS_Screen: U4.12 (CS), U10.6 (GPIO4)
D/C: U4.10 (D/C), U10.7 (GPIO5)
ENC_A: U10.11 (GPIO8); also elsewhere on the board
ENC_B: U10.12 (GPIO9); also elsewhere on the board
ENC_SW: U7.19 (P16); also elsewhere on the board
Earth: C19.2, J5.1, J8.1, J9.1, J10.1, J12.1, U3.2 (GND), U4.13 (GND), U7.2 (A1), U7.12 (GND), U7.21 (A0), U10.3 (GND), U10.8 (GND), U10.13 (GND), U10.18 (GND), U10.23 (GND), U10.28 (GND), U10.33 (AGND), U10.38 (GND); also elsewhere on the board
Fan_EN: R34.2, U7.17 (P14)
IN1: J7.3, U7.13 (P10)
IN2: J7.4, U7.14 (P11)
IN3: J7.5, U7.15 (P12)
IN4: J7.6, U7.16 (P13)
Indicator_Update: U10.17 (GPIO13); also elsewhere on the board
Interrupt: U7.1 (INT), U10.4 (GPIO2)
LED_PWM: JP1.2 (B), U3.12 (GP9); also elsewhere on the board
L_SW: U7.4 (P00); also elsewhere on the board
MISO: U4.6 (SDO(MISO)), U10.16 (GPIO12)
MISO2: J5.3, U10.21 (GPIO16); also elsewhere on the board
MOSI: U4.9 (SDI(MOSI)), U10.15 (GPIO11)
MOSI2: J5.4, U10.25 (GPIO19)
unnamed: D9.1 (K), U3.1 (5V)
unnamed: D10.1 (K), U10.39 (VSYS)
unnamed: J12.2, Q11.3 (S)
unnamed: Q11.2 (G), R34.1
unnamed: R22.2, U7.3 (Reset)
PWM1: J7.1, JP1.1 (A), U10.19 (GPIO14)
PWM2: J7.2, U10.20 (GPIO15)
RX_Pico: U3.9 (GP21), U10.2 (GPIO1)
R_SW: U7.18 (P15); also elsewhere on the board
Relay_CTRL: U10.29 (GPIO22); also elsewhere on the board
Reset_Low: U3.11 (GP10), U10.30 (RUN)
Reset_Screen: U4.11 (Reset), U10.9 (GPIO6)
SCK: U4.8 (SCK), U10.14 (GPIO10)
SCK2: J5.5, U10.24 (GPIO18); also elsewhere on the board
SCL: U7.22 (SCL), U10.27 (GPIO21)
SDA: U7.23 (SDA), U10.26 (GPIO20)
Shift_CLK: U10.10 (GPIO7); also elsewhere on the board
Shift_Clear: U7.9 (P05); also elsewhere on the board
Shift_IN: U10.22 (GPIO17); also elsewhere on the board
T1-CS: U10.31 (GPIO26_ADC0); also elsewhere on the board
T2-CS: U10.32 (GPIO27_ADC1); also elsewhere on the board
TX_Pico: U3.10 (GP20), U10.1 (GPIO0)
Thermistor_Analog: U10.34 (GPIO28_ADC2); also elsewhere on the board

Notes on the sheet:
Main Controller
I2C I/O Expander
Connect rear jumper on module for 3.3V operation
Device Screen
uSD Card Module
MicroSD Socket Module (AliExpress)
In Case UART? communication doesn't work
Not used unless I add a vent fan and electronic dampers
Fan Control Output
Web I/O Controller + LED PWM
Reset the pico by pulling the Reset_Low signal to GND (~50k pull up normally)
Connect to panel mount switch
Vent Fan & Electronic Dampers
Connect to TP6 on Pico for programming
Stepper/Servo Motor Driver Outputs
Bridge if communication with ESP-32 doesn't work

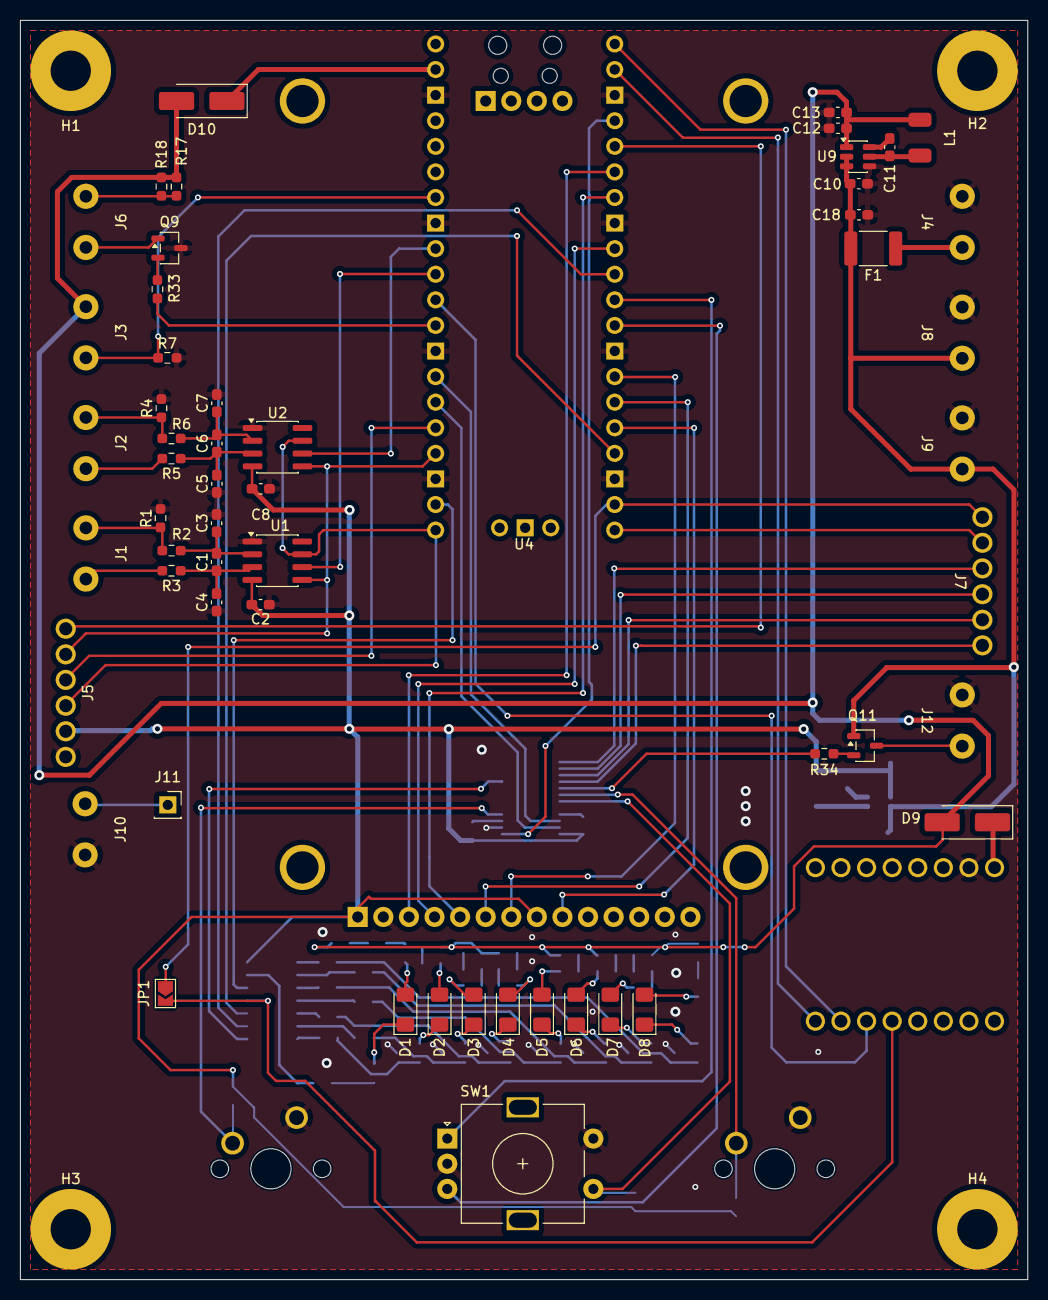
[picture p20: board Solder-Oven-PCB-V1.kicad_pcb from above]

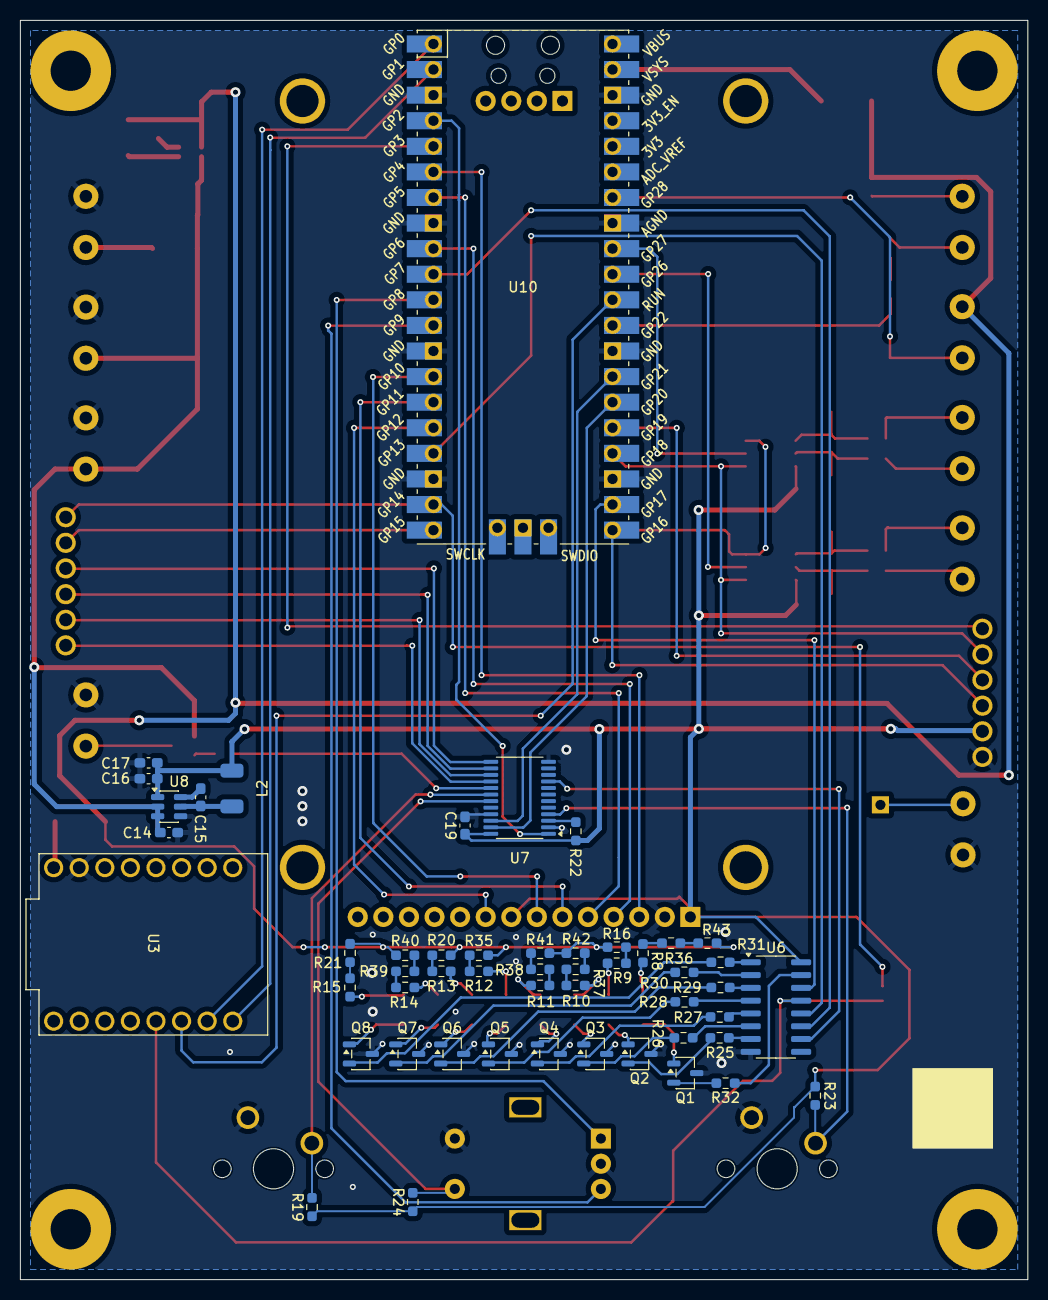
[picture p21: board Solder-Oven-PCB-V1.kicad_pcb from below]

Board: 2 copper layers, 100.0 x 125.0 mm, 113 parts (51 on the bottom side), 107 nets.
